ElectronicCats/BastWAN/Hardware/Bast_WAN.pdf

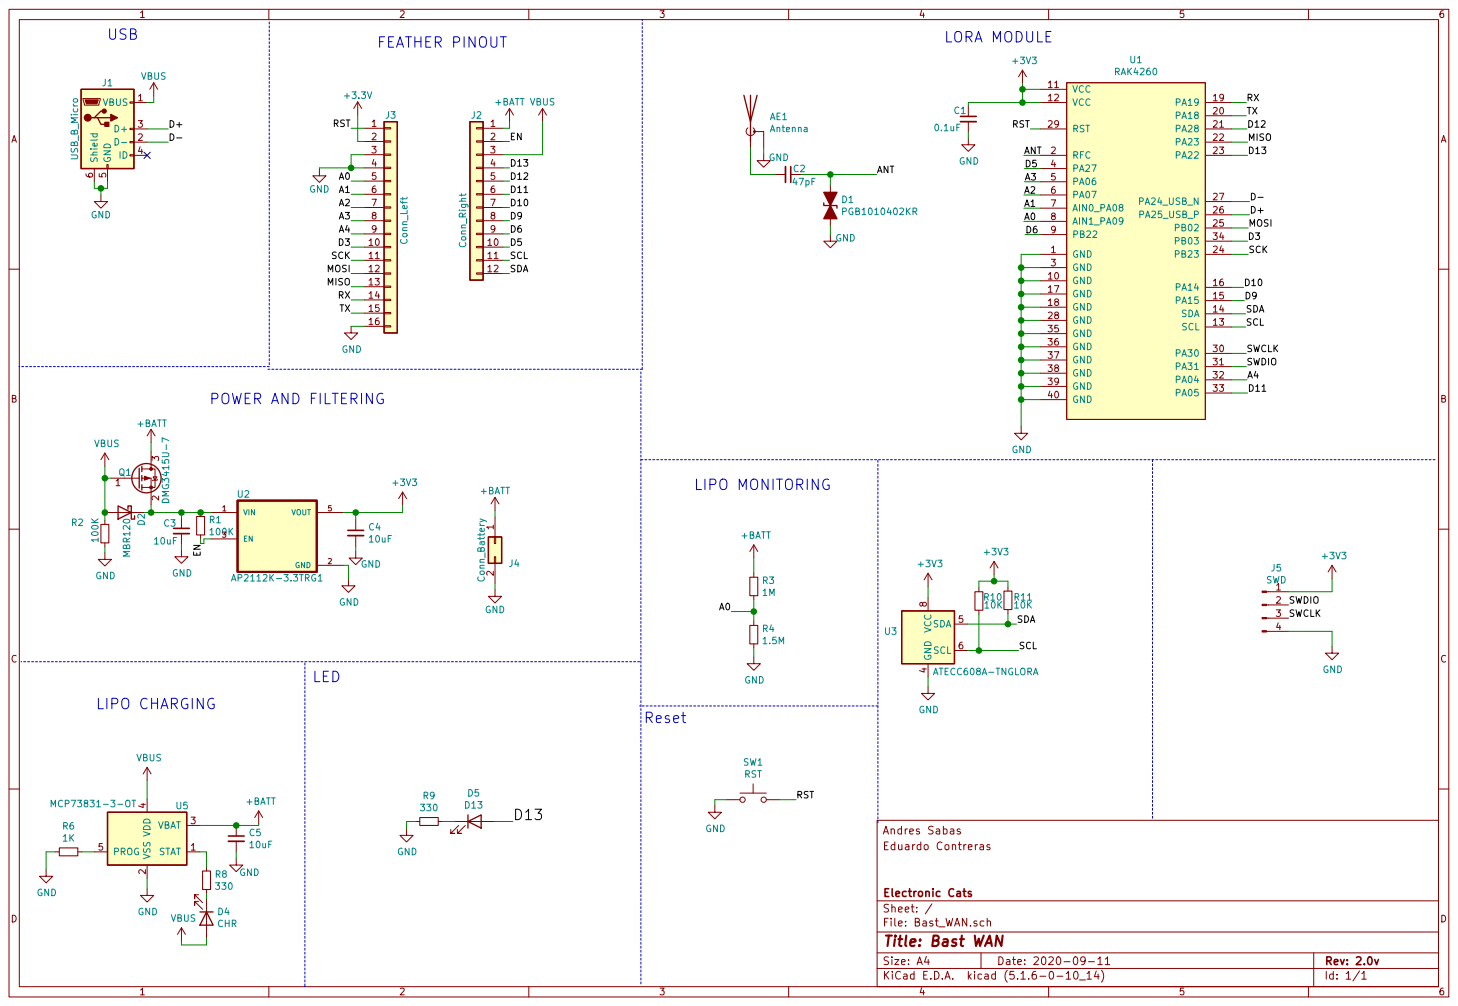
[picture p1: page 1]

File: Bast_WAN.sch Sheet: / Electronic Cats Eduardo Contreras Andres Sabas

Id: 1/1 Title: Bast WAN
