ElectronicCats/BastWAN/(threads)

Thread 1 (2020-01-29):

"Sender" Example Code Bootlooping

Jordandarabos, 2020-01-29:
Hey,

When I upload the "sender" example code to the RAK4260 with the ElectronicCats bootloader installed it gets stuck in a bootloop(the receiver code works fine).  When I comment out the "LoRa.endPacket()" line it will run through the program but will not send any packets(as expected). So I expect that this is the issue but I can't quite figure out _why_. Please help. Thanks!

UPDATE 1/29:

So... my power supply ended up being bad which was causing a voltage dip during transmission. New power supply... Now the program runs fine however It's not sending any packets. In the serial monitor I get the first "Sending packet: 0" but then the LED just goes on and off with no more data in the serial monitor and nothing being received by my receiver(which I've confirmed works with another LoRa module.)

sabas1080, 2020-01-30:
@Jordandarabos what version of the Arduino Core Electronic cats do you have?

Jordandarabos, 2020-01-30:
Hey Sabas,

Thanks for the reply! I’m currently running version 1.0.6.

Jordandarabos, 2020-01-30:
Hey,

So I was using the Radiohead library on the receiver module... I just thought to maybe switch over to the Sandeepmistry lib and now it works fine... Still doesn't show anything in the "sending" serial monitor from the RAK4260 but I'm now receiving the packets. So I guess it works fine and I'm just an idiot lol.

sabas1080, 2020-01-31:
@Jordandarabos keep us up to date and let us know if your problem is solved, we are willing to help

Jordandarabos, 2020-01-31:
@sabas1080  It seems to be working fine now... Have you guys had any luck using the sleep modes with the Arduino IDE? I can get it to work with RAKS example code but I was hoping to use the Arduino IDE. Thanks!

sabas1080, 2020-02-01:
Do you have examples? We can try port examples to arduino @Jordandarabos

Jordandarabos, 2020-02-01:
@Sabas I was able to get this one working in Atmel Studio and got my power consumption down to 1uA! It would be awesome to be able to use it in the Arduino IDE!

RAK4260 low power demo https://github.com/RAKWireless/RAK4260_Low_Power_demo

Jordandarabos, 2020-02-01:
@sabas1080*

sabas1080, 2020-02-01:
ok, I have open issue for your request feature #2

Closed 2020-02-01.

Thread 2 (2020-02-01):

Sleep modes with the Arduino IDE

sabas1080, 2020-02-01:
Sleep modes with the Arduino IDE

Examples
https://github.com/RAKWireless/RAK4260_Low_Power_demo

Jordandarabos, 2020-02-01:
Thank you! This would be amazing!

Jordandarabos, 2020-03-05:
Hey there, just checking to see if any progress has been made on this? I can't seem to figure it out.

glenmurphy, 2020-08-08:
I'm looking for the same. I found some [Arduino sleep code for the SAM R34](https://github.com/riotnetwork/samr/tree/master/libraries/StampLowPower), but it's for a different board than the RAK, so won't work as-is, but might be a good starting point.

sabas1080, 2020-08-09:
Hi @glenmurphy thanks!

@Jordandarabos
SAMR34 and RAK4260 now support sleep modes please use our fork of the libraries
RTCZero https://github.com/ElectronicCats/RTCZero
ArduinoLowPower https://github.com/ElectronicCats/ArduinoLowPower

:D

glenmurphy, 2020-08-10:
So-far I haven't been able to get this to fully work on a raw RAK4260, including the new RTCZero code plus the PR on the boards:
- idle() returns immediately
- sleep() freezes execution and drops the current draw from ~20mA to ~5mA
- sleep(time) does not return
- attachInterruptWakeup doesn't appear to work (tried Bast WAN pins A2, A3, D10)

Given the higher current draw and lack of wakeup, my suspicion is that it's halting partway through the sleep() code - will comment out / bisect when I get a chance.

sabas1080, 2020-08-10:
@glenmurphy yesterday I fix a error with RTCZero
 https://github.com/ElectronicCats/RTCZero/commit/57dc030044838243d3c5a399154eb71b93d9813a

you have the latest changes?

Jordandarabos, 2020-09-22:
Just an update on this.. We're working through some things with the RTCZero Library. For the record this is what we've found:

1.  sleep() is getting stuck during the while loop at line 122(while ((OSC32KCTRL->STATUS.reg & OSC32KCTRL_STATUS_XOSC32KRDY) == 0);). It seems to be an clock issue so that got us looking at the RTCZero Library.

2. We found the the none of the RTCZero examples work, which we're investigating now. Will update with anything that we find but was wondering if you were able to get the RTCZero examples to work @sabas1080 ?

sabas1080, 2020-09-22:
Hi @Jordandarabos

I have not been able to find the error, the library works with me for times, welcome your help

Jordandarabos, 2020-09-22:
Hey @sabas1080

Thanks for the quick response! That's odd because when we upload the example sketch SimpleRTC  it just prints "00/00/00 00:00:00" Over and over. We're going to do some testing today to see what might be causing the issue.

Jordandarabos, 2020-09-22:
Hey @sabas1080

So very strange results so far... We can get the RTCZero examples to work by adding a whole bunch of serial prints in random spots in RTCZero.cpp, which is bizarre. This also caused the low power mode sketch to follow through (still only getting down to about 3-4ma) but at least the sketch doesn't freeze. The interrupt seems to wake up the device and work properly. Any ideas on why affect the RTCZero examples? Also, I noticed there are different sleep modes for the RAK4260. Is it possible we're going into the wrong mode which is why the consumption is so high? Just thinking out loud. Will update when we if we stumble upon anything else. Thank you.

sabas1080, 2020-09-23:
@Jordandarabos that may be the reason it works for me sometimes, what are the different sleep modes for the RAK4260?

Jordandarabos, 2020-09-23:
@sabas1080 @plachta-zabatt

So regarding the prints in RTCZero.cpp, seems like if we put a 10ms delay on line 135 it works. Which makes me wonder if the function RTCisSyncing() is actually doing its job? I'm not familiar enough with it to know but we'll keep digging.

The different modes are located here >https://github.com/RAKWireless/RAK4260_Low_Power_demo/blob/master/APPS_LOW_POWER3_debug/APPS_LOW_POWER3/src/low_power_demo.c

starting on line 671. I've listed them below for convenience:

-ACTIVE mode: Performance Level 0 at 12MHz
-ACTIVE mode: Performance Level 2 at 48MHz
-IDLE mode: Performance Level 0 at 12MHz
-STANDBY mode:PD0,PD1 and PD2 in retention state
-BACKUP mode
-OFF mode

sabas1080, 2020-09-23:
Is correct, I have added the delay and it works, could be a temporary patch

wero1414, 2020-09-23:
we tried to acces by RTC->MODE2.SYNCBUSY.bit.CLOCKSYNC bit only and nothing changed so the behaviour is kinda weird maybe is it bad defined on the CMSIS? i dont know

blackrosezy, 2020-12-16:
Any update on this implementation? Currently the lowest I can get is 2mA in sleep mode

sabas1080, 2020-12-16:
@blackrosezy 2mA is the lowest you currently get

Jakub-Nagy, 2020-12-29:
I was trying to setup sleep on the SAM R34 as well but with little luck.

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

I got these exact results. The code just stops executions and never wakes no matter what I do.

> I'm looking for the same. I found some [Arduino sleep code for the SAM R34](https://github.com/riotnetwork/samr/tree/master/libraries/StampLowPower), but it's for a different board than the Bast-WAN/RAK, so won't work as-is, but might be a good starting point.

So I tried burning the bootloader for this core and I tried out their low power examples. The advantage is that there the processor actually wakes from it's sleep. But I measured around 3.7mA in IDLE mode, which was the same as with the ArduinoLowPower library. When I let it sleep in the BACKUP mode, I got down to 790uA, which is still much higher than the 790nA specified by the datasheet.

The breakout board shouldn't take much current by itself. Maybe the cheapo multimeters have problems at these low values. I'll probably create an issue at the RIOT R34 Stamp repo to find out what's the issue.

sabas1080, 2020-12-29:
@Jakub-Nagy

the changes I made in the libraries are based on the work of RIOTNetwork, It should work the same, if you find any difference let me know and we will comment, welcome your suggestions

To achieve this current you must have the minimum number of elements working, the 790nA is only the chip, a good average should be about 500uA

Jakub-Nagy, 2020-12-29:
> the changes I made in the libraries are based on the work of RIOTNetwork, It should work the same, if you find any difference let me know and we will comment, welcome your suggestions

Well, as I said with RIOT the waking up from sleep is possible, in the libraries linked here it is not. The only way I can wake up the processor is by reseting it altogether.

> good average should be about 500uA

I mean that's probably okay, but it's kinda sad knowing that it should be able to get much lower.

> 790nA is only the chip

So do you know what's the rest? Is it components on the breakout board?

sabas1080, 2020-12-29:
@Jakub-Nagy
> Well, as I said with RIOT the waking up from sleep is possible, in the libraries linked here it is not. The only way I can wake up the processor is by reseting it altogether.

maybe some changes are necessary in our core for it to work correctly
 https://github.com/riotnetwork/samr/commit/959d6563cbfb3bb70506627a99acd5f1e2f6a80d
https://github.com/riotnetwork/samr/commit/dc40495a447d154cc347ec6fb0c16c0308e24658
https://github.com/riotnetwork/samr/commit/26d41461ab7a236ea1c679e5a56de1a4458ae020
https://github.com/riotnetwork/samr/commit/d4a60a6aa903b5fe6ecce7d1605359dd33ef54cc
https://github.com/riotnetwork/samr/commit/d47a467a1728bf744bd06a20385252d7a0903705

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

to improve the current level you will have to use Microchip / Atmel tools and optimize your hardware to the maximum, you must consider consumption of the regulator, LEDs, resistors and sensors that must also enter low consumption mode or not place them, example https://diyi0t.com/reduce-the-esp32-power-consumption/

Jakub-Nagy, 2020-12-30:
> to improve the current level you will have to use Microchip / Atmel tools and optimize your hardware to the maximum

Maybe that's currently the only way.

> consider consumption of the regulator, LEDs, resistors and sensors that must also enter low consumption mode or not place them

Yes I'll definitely do that on my own hardware. But even on [this breakout board](https://www.tindie.com/products/makertronika-labs/penguino-feather-samr34-lora-dev-board/), the maker from Tindie states that the consumption of the board itself (without the chip) is only 9ua, plus the 890nA of the chip that should total at 10uA, not at nearly 800uA. I will try to find out more.

sabas1080, 2020-12-30:
> Yes I'll definitely do that on my own hardware. But even on [this breakout board](https://www.tindie.com/products/makertronika-labs/penguino-feather-samr34-lora-dev-board/), the maker from Tindie states that the consumption of the board itself (without the chip) is only 9ua, plus the 890nA of the chip that should total at 10uA, not at nearly 800uA. I will try to find out more.
the maker of this board recommend Atmel Studio 7 or Mbed

Jakub-Nagy, 2020-12-30:
> the maker of this board recommend Atmel Studio 7 or Mbed

Atmel Studio works but it lacks documentation and Mbed works but with much much larger hoops than with Arduino.

blackrosezy, 2020-12-31:
I just want to share my setup to test the sleep current (I'm using Joulescope from JetPerch) for the RAK4260 (https://store.rakwireless.com/products/rak4260-breakout-board).

First I'm using firmware from https://github.com/RAKWireless/RAK4260_Low_Power_demo. The lowest current that I can get is **~700nA** in Standby mode.

Using the same hardware setup, I'm using the library from https://github.com/ElectronicCats/ArduinoLowPower, the lowest current in sleep mode that I can get is around **~2mA**.

Currently I'm comparing the code from https://github.com/RAKWireless/RAK4260_Low_Power_demo and https://github.com/ElectronicCats/ArduinoLowPower to see which area that can be improved.

Here are my hardware setup:

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

h-filzer, 2021-03-12:
I got the BastWan power consumption down to 120uA with RIOT OS in STANDBY Mode and down to 80uA in BACKUP mode.
From my view the LDO takes roughly 50uA [AP2112K-3.3TRG1 Dtasheet](https://www.mouser.de/datasheet/2/115/AP2112-271550.pdf) plus 5uA for the LiPo Charger MCP73831 negleting power demand of the ATECC608A and coarse measured the 1uA for the Battery voltage divider (r3/r4).
To verify it would be very supporting if we would know about the power consumption in STANDBY mode  of the MCU itself e.g. using the breakout board. @blackrosezy  Did you measure also the STANDBY mode power consumption and like to share your results? This might give me a hint to further investigate power leaks or to judge if we are fine with it for now.
For anyone to x-check measurements see [bastwan branch for RIOT OS](/h-filzer/RIOT/tree/bastwan) and example project including LoraWan https://github.com/h-filzer/samr34-lorawan-smt50

Closed 2022-10-10.

Thread 6 (2020-09-22):

[Help] Flashing UF2 USB bootloader

jaimelaborda, 2020-09-22:
Hi,

I just wanted to know if there is a guide to or something like that to flash the BastWAN, I have just built some boards myself but I don't know where the UF2 USB bootloader can be found.

Best regards,
Jaime.

sabas1080, 2020-09-22:
Hi @jaimelaborda

The bootloader is in our Arduino Core https://github.com/ElectronicCats/ArduinoCore-samd/tree/master/bootloaders/bastwan

if you can send us photos of your boards, we would love to see them

jaimelaborda, 2020-09-23:
Hi @sabas1080

Thank you very much for your reply and help.

I have managed to successfully upload the bootloader to the board using a JLink and the .bin you provide me! Cool!!

I attach you some photos of our boards (we are from [MakersUPV](http://makersupv.com/ at Valencia, Spain). I have to thank you and the ElectronicsCats team for bringing that cool board to the open-source community. I love feather board form factor, and having Arduino support for RAK chips is awesome!. You guys have done a great job! Viva Mexico!!

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

Stay safe.

Best regards,
Jaime.

sabas1080, 2020-09-23:
Nice work!

Un abrazo hasta la madre patria

Closed 2020-09-23.

Thread 7 (2020-12-27):

LoRaWAN and pinouts

Jakub-Nagy, 2020-12-27:
Hello there!

I'm also trying to resolve this issue on [the TTN forum](https://www.thethingsnetwork.org/forum/t/sam-r34-lorawan/42447) but here I'm just looking at the BastWAN core aspect.

I recently bought [this SAM R34 evaluation board](https://www.tindie.com/products/makertronika-labs/penguino-feather-samr34-lora-dev-board/) from Tindie with hopes to get to know the processor before doing a custom HW implementation.

After experimentation with ASF and Mbed OS, I was happy I found this Arduino core for the RAK4260 (so also for SAM R34). I managed to burn the UF2 bootloader and upload and test simple Arduino sketches. I managed to get a direct LoRa link working using the [Arduino LoRa library](https://www.arduino.cc/reference/en/libraries/lora/). This worked well.

I ran into problems when trying to use LoRaWAN though. I tried using a modified [TinyLoRa](https://github.com/adafruit/TinyLoRa) version, [the Beelan-LoRaWAN library](https://github.com/BeelanMX/Beelan-LoRaWAN) with the example from this repo and also [the Arduino LMIC library](https://github.com/mcci-catena/arduino-lorawan).

When using the TinyLoRa test sketch, the serial output (with memory register debug printouts) looks exactly the same as it does with a working Arduino + SX1276 circuit. But I'm definitely in range of the gateway and I have correct keys. I tried both OTAA and ABP.

When using the Beelan example found on this repo, the printout also acted as if the transmission was happening normally. When I turned on memory register debug printouts though, I found out that the communication with then chip happened only during initialization and there was no communication when transmitting. Again, I didn't receive anything on the TTN console neither with OTAA or ABP.

When I uploaded the LMIC test sketch (with correct pinouts and everything), the processor just crashed and wouldn't communicate. I needed to reburn the bootloader.

I also need to ask about the pinouts. I found out that direct LoRa transmissions only work if the RFM_SWITCH is set to high. Apparently the status of RFM_RFSW_ON and RFM_TCX_ON doesn't affect this at all. I can not find the RX/TX pin in the pin map though. What is the system in this pin mapping? I couldn't find any correlation between the [BastWAN pin map](https://github.com/ElectronicCats/ArduinoCore-samd/blob/master/variants/bastwan/variant.h) and the [RAK4260 pinout](https://docs.rakwireless.com/Product-Categories/WisDuo/RAK4260-Module/Datasheet/#pin-definition) or even the [SAM R34 pinout](https://www.mouser.sk/pdfdocs/SAMR34-R35-Low-Power-LoRa-Sub-GHz-SiP-Data-Sheet-DS70005356B-2.pdf). Not one pin number seems to match. Does anyone know how the pin mapping is made?

If anyone can advise me about any of this I would really appreciate that. I would like to use this core but it's very hard at the moment. Thanks!

sabas1080, 2020-12-27:
Hi @Jakub-Nagy

BastWAN and Penguino Feather SAMR34 are not the same in pinout and schematic, that causes the [arduino variant](https://github.com/ElectronicCats/ArduinoCore-samd/tree/master/variants/bastwan) maybe not able to work.

our support is focused on Beelan library, please use [this branch](https://github.com/BeelanMX/Beelan-LoRaWAN/pull/58) this may fix your problem i am almost sure and test if work, RFM_RFSW_ON and RFM_TCX_ON are configured in our arduino core and the Beelan library

Jakub-Nagy, 2020-12-28:
> BastWAN and Penguino Feather SAMR34 are not the same in pinout and schematic, that causes the [arduino variant](https://github.com/ElectronicCats/ArduinoCore-samd/tree/master/variants/bastwan) maybe not able to work.

Tried this but unfortunately didn't help me. Luckily I was able to find this [BastWAN pinout](https://hackster.imgix.net/uploads/attachments/1186015/image_pOIMWWvGYf.png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) and compare it with this [Penguino pinout](https://drive.google.com/file/d/1xNMF-pdmZ0RDsIqiBhjT6byVtGZHqqaZ/view). When I compared them, that the RFM_SWITCH was the same in both of them, but the RFM_RFSW_ON was different (it was pin 17 on the Penguino). Thanks to this I was able to make LoRaWAN uplink work at least with TinyLoRa. This means that the hardware works.

Though in the future I would rather use Beelan since it also supports downlinks and has some other features. When using the send-class-A-ABP.ino example (with the same pinout as with the functioning TinyLoRa sketch), I get this output:
`22:29:24.793 -> Sending: Counter-0
22:29:24.793 -> SPI Write ADDR: 1 DATA: 81
22:29:24.793 -> SPI Write ADDR: 1E DATA: C4
22:29:24.793 -> SPI Write ADDR: 1D DATA: 72
22:29:24.793 -> SPI Write ADDR: 26 DATA: 4
22:29:24.793 -> SPI Write ADDR: 6 DATA: D8
22:29:24.793 -> SPI Write ADDR: 7 DATA: EC
22:29:24.793 -> SPI Write ADDR: 8 DATA: F1
22:29:24.793 -> SPI Write ADDR: 40 DATA: 40
22:29:24.793 -> SPI Write ADDR: 33 DATA: 27
22:29:24.793 -> SPI Write ADDR: 3B DATA: 1D
22:29:24.793 -> SPI Write ADDR: 22 DATA: 16
22:29:24.793 -> SPI Read ADDR: E DATA: 80
22:29:24.793 -> SPI Write ADDR: D DATA: 80
22:29:24.828 -> SPI Write ADDR: 0 DATA: 40
22:29:24.828 -> SPI Write ADDR: 0 DATA: F1
22:29:24.828 -> SPI Write ADDR: 0 DATA: 3F
22:29:24.828 -> SPI Write ADDR: 0 DATA: 1
22:29:24.828 -> SPI Write ADDR: 0 DATA: 26
22:29:24.828 -> SPI Write ADDR: 0 DATA: 0
22:29:24.828 -> SPI Write ADDR: 0 DATA: 0
22:29:24.828 -> SPI Write ADDR: 0 DATA: 0
22:29:24.828 -> SPI Write ADDR: 0 DATA: 1
22:29:24.828 -> SPI Write ADDR: 0 DATA: D0
22:29:24.828 -> SPI Write ADDR: 0 DATA: 9F
22:29:24.828 -> SPI Write ADDR: 0 DATA: FE
22:29:24.828 -> SPI Write ADDR: 0 DATA: 78
22:29:24.828 -> SPI Write ADDR: 0 DATA: D4
22:29:24.828 -> SPI Write ADDR: 0 DATA: 9B
22:29:24.828 -> SPI Write ADDR: 0 DATA: 3F
22:29:24.828 -> SPI Write ADDR: 0 DATA: 53
22:29:24.828 -> SPI Write ADDR: 0 DATA: 48
22:29:24.828 -> SPI Write ADDR: 0 DATA: 86
22:29:24.828 -> SPI Write ADDR: 0 DATA: 61
22:29:24.828 -> SPI Write ADDR: 0 DATA: 83
22:29:24.828 -> SPI Write ADDR: 0 DATA: 87
22:29:24.828 -> SPI Write ADDR: 1 DATA: 83
22:29:26.146 -> SPI Write ADDR: 12 DATA: 8
22:29:27.144 -> SPI Write ADDR: 40 DATA: 0
22:29:27.144 -> SPI Write ADDR: 33 DATA: 67
22:29:27.144 -> SPI Write ADDR: 3B DATA: 19
22:29:27.144 -> SPI Write ADDR: 6 DATA: D8
22:29:27.144 -> SPI Write ADDR: 7 DATA: EC
22:29:27.144 -> SPI Write ADDR: 8 DATA: F1
22:29:27.144 -> SPI Write ADDR: 1 DATA: 86
22:29:28.356 -> SPI Write ADDR: 12 DATA: E0
22:29:28.356 -> SPI Write ADDR: 40 DATA: 0
22:29:28.356 -> SPI Write ADDR: 33 DATA: 67
22:29:28.356 -> SPI Write ADDR: 3B DATA: 19
22:29:28.356 -> SPI Write ADDR: 6 DATA: D9
22:29:28.356 -> SPI Write ADDR: 7 DATA: 61
22:29:28.356 -> SPI Write ADDR: 8 DATA: BE
22:29:28.356 -> SPI Write ADDR: 1 DATA: 86
22:29:29.573 -> SPI Write ADDR: 12 DATA: E0
`
The printouts act as if it was transmitting normally but I don't receive anything.

I was also looking into the Config.h file inside the Beelan library. I found the following:
`// #define AS_923
#define EU_868
//#define US_915 1
//#define AU_915 1`

Why don't the first two regions have a 1 while the second ones do? I would understand if 1 means enabled and without 1 it's disabled. But some with 1 are commented out by default. Why is this different?

Even if I don't get LoRaWAN working with Beelan, I can at least make it work with TinyLoRa. I have a checklist with different features I need to test on this processor before it can be implemented in new hardware. The last items remaining are: ADC, Writing into flash during runtime and software sleep/standby. But I doubt there will be issues with the first two.

I was trying out the examples from the ArduinoLowPower library. They won't even compile. I get many different compilation errors like these:
`C:\Users\nagyk\Documents\Arduino\libraries\ArduinoLowPower-master\src\samd\ArduinoLowPower.cpp:8:8: error: 'struct Gclk' has no member named 'CLKCTRL'
  GCLK->CLKCTRL.bit.CLKEN = 0; //disable GCLK module
        ^
C:\Users\nagyk\Documents\Arduino\libraries\ArduinoLowPower-master\src\samd\ArduinoLowPower.cpp:9:15: error: 'struct Gclk' has no member named 'STATUS'
  while (GCLK->STATUS.bit.SYNCBUSY);
               ^
C:\Users\nagyk\Documents\Arduino\libraries\ArduinoLowPower-master\src\samd\ArduinoLowPower.cpp:11:8: error: 'struct Gclk' has no member named 'CLKCTRL'
  GCLK->CLKCTRL.reg = (uint16_t) (GCLK_CLKCTRL_CLKEN | GCLK_CLKCTRL_GEN_GCLK6 | GCLK_CLKCTRL_ID( GCM_EIC )) ;  //EIC clock switched on GCLK6
        ^
C:\Users\nagyk\Documents\Arduino\libraries\ArduinoLowPower-master\src\samd\ArduinoLowPower.cpp:11:34: error: 'GCLK_CLKCTRL_CLKEN' was not declared in this scope
  GCLK->CLKCTRL.reg = (uint16_t) (GCLK_CLKCTRL_CLKEN | GCLK_CLKCTRL_GEN_GCLK6 | GCLK_CLKCTRL_ID( GCM_EIC )) ;  //EIC clock switched on GCLK6
                                  ^
C:\Users\nagyk\Documents\Arduino\libraries\ArduinoLowPower-master\src\samd\ArduinoLowPower.cpp:11:55: error: 'GCLK_CLKCTRL_GEN_GCLK6' was not declared in this scope
  GCLK->CLKCTRL.reg = (uint16_t) (GCLK_CLKCTRL_CLKEN | GCLK_CLKCTRL_GEN_GCLK6 | GCLK_CLKCTRL_ID( GCM_EIC )) ;  //EIC clock switched on GCLK6
                                                       ^
C:\Users\nagyk\Documents\Arduino\libraries\ArduinoLowPower-master\src\samd\ArduinoLowPower.cpp:11:105: error: 'GCLK_CLKCTRL_ID' was not declared in this scope
  GCLK->CLKCTRL.reg = (uint16_t) (GCLK_CLKCTRL_CLKEN | GCLK_CLKCTRL_GEN_GCLK6 | GCLK_CLKCTRL_ID( GCM_EIC )) ;  //EIC clock switched on GCLK6
                                                                                                         ^
C:\Users\nagyk\Documents\Arduino\libraries\ArduinoLowPower-master\src\samd\ArduinoLowPower.cpp:12:15: error: 'struct Gclk' has no member named 'STATUS'
  while (GCLK->STATUS.bit.SYNCBUSY);
               ^
C:\Users\nagyk\Documents\Arduino\libraries\ArduinoLowPower-master\src\samd\ArduinoLowPower.cpp:14:16: error: request for member 'reg' in '1073747968u->Gclk::GENCTRL', which is of non-class type 'volatile GCLK_GENCTRL_Type [9]'
  GCLK->GENCTRL.reg = (GCLK_GENCTRL_GENEN | GCLK_GENCTRL_SRC_OSCULP32K | GCLK_GENCTRL_ID(6));  //source for GCLK6 is OSCULP32K
                ^
C:\Users\nagyk\Documents\Arduino\libraries\ArduinoLowPower-master\src\samd\ArduinoLowPower.cpp:14:90: error: 'GCLK_GENCTRL_ID' was not declared in this scope
  GCLK->GENCTRL.reg = (GCLK_GENCTRL_GENEN | GCLK_GENCTRL_SRC_OSCULP32K | GCLK_GENCTRL_ID(6));  //source for GCLK6 is OSCULP32K
                                                                                          ^
C:\Users\nagyk\Documents\Arduino\libraries\ArduinoLowPower-master\src\samd\ArduinoLowPower.cpp:15:15: error: 'struct Gclk' has no member named 'STATUS'
  while (GCLK->STATUS.reg & GCLK_STATUS_SYNCBUSY);
               ^
`...There is much more of these but are very similar. Do you know what might be the source of this?

But I also read in the issue "Sleep modes with the Arduino IDE #2" that currently even with the sleep mode enabled the minimum current is 2mA. In the application I'm developing it's crucial to have 500uA and below. Is there any roadmap for the implementation of the other sleep modes? Is it planned at all? Thank you very much.

sabas1080, 2020-12-28:
> Tried this but unfortunately didn't help me. Luckily I was able to find this [BastWAN pinout](https://hackster.imgix.net/uploads/attachments/1186015/image_pOIMWWvGYf.png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) and compare it with this [Penguino pinout](https://drive.google.com/file/d/1xNMF-pdmZ0RDsIqiBhjT6byVtGZHqqaZ/view). When I compared them, that the RFM_SWITCH was the same in both of them, but the RFM_RFSW_ON was different (it was pin 17 on the Penguino). Thanks to this I was able to make LoRaWAN uplink work at least with TinyLoRa. This means that the hardware works.

excellent that your board now works.

We define pinout for LoRA Radio with [macros in Arduino IDE](https://github.com/ElectronicCats/ArduinoCore-samd/blob/master/variants/bastwan/variant.h#L132) and Beelan library use that [macros in the code](https://github.com/BeelanMX/Beelan-LoRaWAN/pull/58/commits/45c5387d45d9fa83df1a43c36eb0a3445c002a5b), we must correct that, but for test [use this version](https://github.com/BeelanMX/Beelan-LoRaWAN/archive/DownlinkTimingFix.zip)

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

I will send pullrequest for fix this

> I was trying out the examples from the ArduinoLowPower library. They won't even compile. I get many different compilation errors like these:

For SAMR34 and our ArduinoCore use our version of the library

RTCZero https://github.com/ElectronicCats/RTCZero
ArduinoLowPower https://github.com/ElectronicCats/ArduinoLowPower

> But I also read in the issue "Sleep modes with the Arduino IDE #2" that currently even with the sleep mode enabled the minimum current is 2mA. In the application I'm developing it's crucial to have 500uA and below. Is there any roadmap for the implementation of the other sleep modes? Is it planned at all? Thank you very much.

Yes, we have ported the arduino version and it is the maximum we have obtained, if you want to contribute to improving performance, welcome and we can discuss in #2

Jakub-Nagy, 2020-12-29:
> use this version

I did use this version the first time. Doesn't matter now.

> I will send pullrequest for fix this

Great. Maybe I just wasn't enabling my region properly.

I'm going to close this issue and reply to the sleep stuff in #2.

Closed 2020-12-29.

Thread 8 (2021-03-16):

SPI flash

henriAbel, 2021-03-16:
Don't see any reference to SPI flash in schematics. Which PIN is used for flash CS?

Jorgeuri, 2021-03-16:
CS is in the D10 (PA14) PIN.

henriAbel, 2021-03-24:
Are there any examples how to read/write from flash? I have tried to adapt some libraries but none of them even detect FLASH.

capuchino69, 2021-03-24:
What version do you have?

> Are there any examples how to read/write from flash? I have tried to adapt some libraries but none of them even detect FLASH.

henriAbel, 2021-03-25:
BAST v2.0 BastWan is behind the PCB

sabas1080, 2021-03-25:
@henriAbel
bastwan v2.0 does not have SPI flash, check schematic https://github.com/ElectronicCats/BastWAN/blob/master/Hardware/Bast_WAN.pdf

version 1.3 and 1.2 included flash, but in new versions we removed SAMR34 it does not support circuitpython

henriAbel, 2021-03-26:
Would be nice to keep repo and store page up to date.
Store still has reference to the 2 MB SPI flash
https://electroniccats.com/store/bastwan/

sabas1080, 2021-03-26:
updated in store, thank you for your comments @henriAbel

Closed 2021-03-25.

Thread 9 (2021-05-14):

LoRaWAN not working with ElectronicCats fork of arduino-lmic

beegee-tokyo, 2021-05-14:
I am trying to get the BastWAN to work on LoRaWAN.
Region US915
Gateway RAK7258 (of course)
Server Chirpstack running on RPi 4

I started with the [BeeLAN library](https://github.com/BeelanMX/Beelan-LoRaWAN) and it works somehow, but it seems to be limited in functionality (`Receiving and processing MAC commands.`). In addition, I need support for AS923-3 in the future, but it is difficult to add new regions.

Next I tried your fork of [arduino-lmic](https://github.com/ElectronicCats/arduino-lmic). But it fails to join. I can see on the gateway the join requests and join accepts, but it seems the app [ttn-otaa-bastwan-us915](https://github.com/ElectronicCats/arduino-lmic/tree/master/examples/ttn-otaa-bastwan-us915) does not receive the join accept.
Gateway log:
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
App log:
```log
Packet queued
49579: EV_JOINING
49680: EV_TXSTART
451194: EV_JOIN_TXCOMPLETE: no JoinAccept
453562: EV_TXSTART
833894: EV_JOIN_TXCOMPLETE: no JoinAccept
1134824: EV_TXSTART
1536367: EV_JOIN_TXCOMPLETE: no JoinAccept
1592096: EV_TXSTART
1972379: EV_JOIN_TXCOMPLETE: no JoinAccept
2659950: EV_TXSTART
3061508: EV_JOIN_TXCOMPLETE: no JoinAccept
3067960: EV_TXSTART
3448286: EV_JOIN_TXCOMPLETE: no JoinAccept
3782371: EV_TXSTART
4183891: EV_JOIN_TXCOMPLETE: no JoinAccept
4205018: EV_TXSTART
4585344: EV_JOIN_TXCOMPLETE: no JoinAccept
4739341: EV_TXSTART
```

Any idea?
I guess I have the pin mapping correct, because I can send.
```C++
// Pin mapping for ElectronicCats BastWAN LoRa
const lmic_pinmap lmic_pins = {
  .nss = SS,
  .rxtx = RFM_SWITCH,
  .rst = RFM_RST,
  .dio = {RFM_DIO0, RFM_DIO1, RFM_DIO2},
  .rxtx_rx_active = 0,
  .rssi_cal = 10,              // LBT cal for the Adafruit Feather M0 LoRa, in dB
  .spi_freq = 8000000,
};
```

wero1414, 2021-05-15:
Hi! This problems seems related to the manage of the Tx/Rx inside the RAK module  i will try to get it to work for implementing the TX and Rx managing on the library

beegee-tokyo, 2021-05-15:
@wero1414
Hi Eduardo,
Anything I can help with?

beegee-tokyo, 2021-06-28:
I have no idea why, but it is working now.
All I had to do was
a) Add `Serial.printf` to the BSP
b) Enable `#define LMIC_PRINTF_TO Serial` in `config.h` in your `arduino-lmic` fork.

Serial log:
```log
TestingPacket queued
33300: EV_JOINING
380072: EV_TXSTART
742360: EV_JOINED
netid: 0
devaddr: 13FF771
AppSKey: F3-8D-12-D2-BA-F7-19-53-F1-88-52-67-D8-90-FE-0C
NwkSKey: 52-19-52-C1-B9-A3-1F-EC-30-CA-67-47-99-76-14-E7
743002: EV_TXCOMPLETE (includes waiting for RX windows)
2618149: EV_TXSTART
Packet queued
2706196: EV_TXCOMPLETE (includes waiting for RX windows)
3903873: EV_TXSTART
3988065: EV_TXCOMPLETE (includes waiting for RX windows)
5061648: EV_TXSTART
5144593: EV_TXCOMPLETE (includes waiting for RX windows)
6091425: EV_TXSTART
6174352: EV_TXCOMPLETE (includes waiting for RX windows)
7121200: EV_TXSTART
7204184: EV_TXCOMPLETE (includes waiting for RX windows)
8150977: EV_TXSTART
8289764: EV_TXCOMPLETE (includes waiting for RX windows)
10164913: EV_TXSTART
Packet queued
10306260: EV_TXCOMPLETE (includes waiting for RX windows)
```

sabas1080, 2021-06-28:
Hi @beegee-tokyo I have fixed some problems in the variant that solve problems in Beelan lorawan library, it may be related to the problems you have

https://github.com/ElectronicCats/ArduinoCore-samd/pull/9

Eric286, 2023-04-17:
Dear @beegee-tokyo

Do you still require assistance with your issue or was it already resolved in another way?

Have a nice day!
Kind regards,

Support Team.

beegee-tokyo, 2023-04-18:
Can be closed. Stopped using BastWAN. Terrible device.

Closed 2023-04-18.

Thread 10 (2021-06-19):

PA13 pin definition

Jakub-Nagy, 2021-06-19:
Hi, just a quick question, what is the pin number/definition for the SAM R34 pin PA13? My board uses it for the RX/TX switching but I can't access it. I tried to find a reference for this pin in the [board variant](https://github.com/ElectronicCats/ArduinoCore-samd/tree/master/variants/bastwan) but wasn't able to find anything. Can anyone help? Thanks.

Jakub-Nagy, 2021-06-20:
Nevermind, I have found out that it is pin 41 or "RFM_SWITCH" and made my device work.

Closed 2021-06-20.
