ElectronicCats/BastWAN/Examples/LoRaWAN/BeelanLoRaWAN_library/send-class-A-ABP/send-class-A-ABP.ino

/**
 * Example of ABP device
 * Authors: 
 *        Ivan Moreno
 *        Eduardo Contreras
 *  June 2019
 * 
 * This code is beerware; if you see me (or any other collaborator 
 * member) at the local, and you've found our code helpful, 
 * please buy us a round!
 * Distributed as-is; no warranty is given.
 */
#include <lorawan.h> // Library Beelan http://librarymanager/All#Beelan

//ABP Credentials 
const char *devAddr = "00000000";
const char *nwkSKey = "00000000000000000000000000000000";
const char *appSKey = "00000000000000000000000000000000";

const unsigned long interval = 10000;    // 10 s interval to send message
unsigned long previousMillis = 0;  // will store last time message sent
unsigned int counter = 0;     // message counter

char myStr[50];
char outStr[255];
byte recvStatus = 0;

const sRFM_pins RFM_pins = {
  .CS = SS,
  .RST = RFM_RST,
  .DIO0 = RFM_DIO0,
  .DIO1 = RFM_DIO1,
  .DIO2 = RFM_DIO2,
  .DIO5 = RFM_DIO5,
};

void setup() {
  // Setup loraid access
  Serial.begin(115200);
  while(!Serial);
  if(!lora.init()){
    Serial.println("RFM95 not detected");
    delay(5000);
    return;
  }
  
  pinMode(RFM_TCX_ON,OUTPUT);
  pinMode(RFM_SWITCH,OUTPUT);
  pinMode(LED_BUILTIN,OUTPUT);
  
  // Set LoRaWAN Class change CLASS_A or CLASS_C
  lora.setDeviceClass(CLASS_A);

  // Set Data Rate
  lora.setDataRate(SF8BW125);

  // set channel to random
  lora.setChannel(MULTI);
  
  // Put ABP Key and DevAddress here
  lora.setNwkSKey(nwkSKey);
  lora.setAppSKey(appSKey);
  lora.setDevAddr(devAddr);
}

void loop() {
  // Check interval overflow
  if(millis() - previousMillis > interval) {
    previousMillis = millis(); 

    sprintf(myStr, "Counter-%d", counter); 

    Serial.print("Sending: ");
    Serial.println(myStr);
    
    lora.sendUplink(myStr, strlen(myStr), 0,1);
    counter++;
  }

  recvStatus = lora.readData(outStr);
  if(recvStatus) {
    Serial.println(outStr);
  }
  
  // Check Lora RX
  lora.update();
}
