ElectronicCats/BastWAN/(commit log)

2019-11-06 init commit
    [Bast_WAN.kicad_pcb, Bast_WAN.sch]
2019-11-06 rename path
    [Bast_WAN.kicad_pcb, Bast_WAN.sch]
2019-11-06 add footprint library
2019-11-06 change traces add floor plan
2019-11-06 add first route V1
    [Bast_WAN.kicad_pcb, Bast_WAN.sch]
2019-11-06 Update traces
    [Bast_WAN.kicad_pcb, Bast_WAN.sch]
2019-11-06 Add manuf# and fix silk
    [Bast_WAN.kicad_pcb, Bast_WAN.sch]
2019-11-06 Add logos
    [Bast_WAN.kicad_pcb]
2019-11-06 add label
    [Bast_WAN.kicad_pcb]
2019-11-07 add labels pins
    [Bast_WAN.kicad_pcb]
2019-12-03 add resistor I2C and SS SPI
    [Bast_WAN.kicad_pcb, Bast_WAN.sch]
2020-01-02 Update version
    [Bast_WAN.kicad_pcb, Bast_WAN.sch]
2020-01-07 add swd standard connector
    [Bast_WAN.kicad_pcb]
2020-01-10 update swd pins
    [Bast_WAN.kicad_pcb, Bast_WAN.sch]
2020-01-10 change the swd silks
    [Bast_WAN.kicad_pcb]
2020-01-10 Change USB add layer stack numbers
    [Bast_WAN.kicad_pcb, Bast_WAN.sch]
2020-01-15 add RAK logo
    [Bast_WAN.kicad_pcb]
2020-03-24 Change ATTEC package SOIC to UDFN
    [Bast_WAN.kicad_pcb, Bast_WAN.sch]
2020-03-24 update manf# to LCSC
    [Bast_WAN.sch]
2020-07-19 change memory for GD25Q16C
    [Bast_WAN.sch]
2020-07-23 Update Rf switch configuration
2020-08-19 V1.3 update
    [Bast_WAN.kicad_pcb, Bast_WAN.sch]
2020-09-11 update schematic
    [Bast_WAN.sch]
2020-09-11 update bastwan 2.0v
    [Bast_WAN.kicad_pcb, Bast_WAN.sch]
2020-09-11 move vias from pads
    [Bast_WAN.kicad_pcb]
2020-09-11 update sch, and manf# missing 2M
    [Bast_WAN.sch]
2020-09-12 update resistor value and manf#
    [Bast_WAN.sch]
2020-12-27 Added example simulator sensors
2020-12-28 update PDF schematic v2.0
2021-03-25 remove circuitpython description
2022-11-23 Changed charge resistance to 4.7K and updated BOM
    [Bast_WAN.csv, Bast_WAN.kicad_sch]
